DeathLock16/STM32-Drone/Drone_3D/Drone-1.png

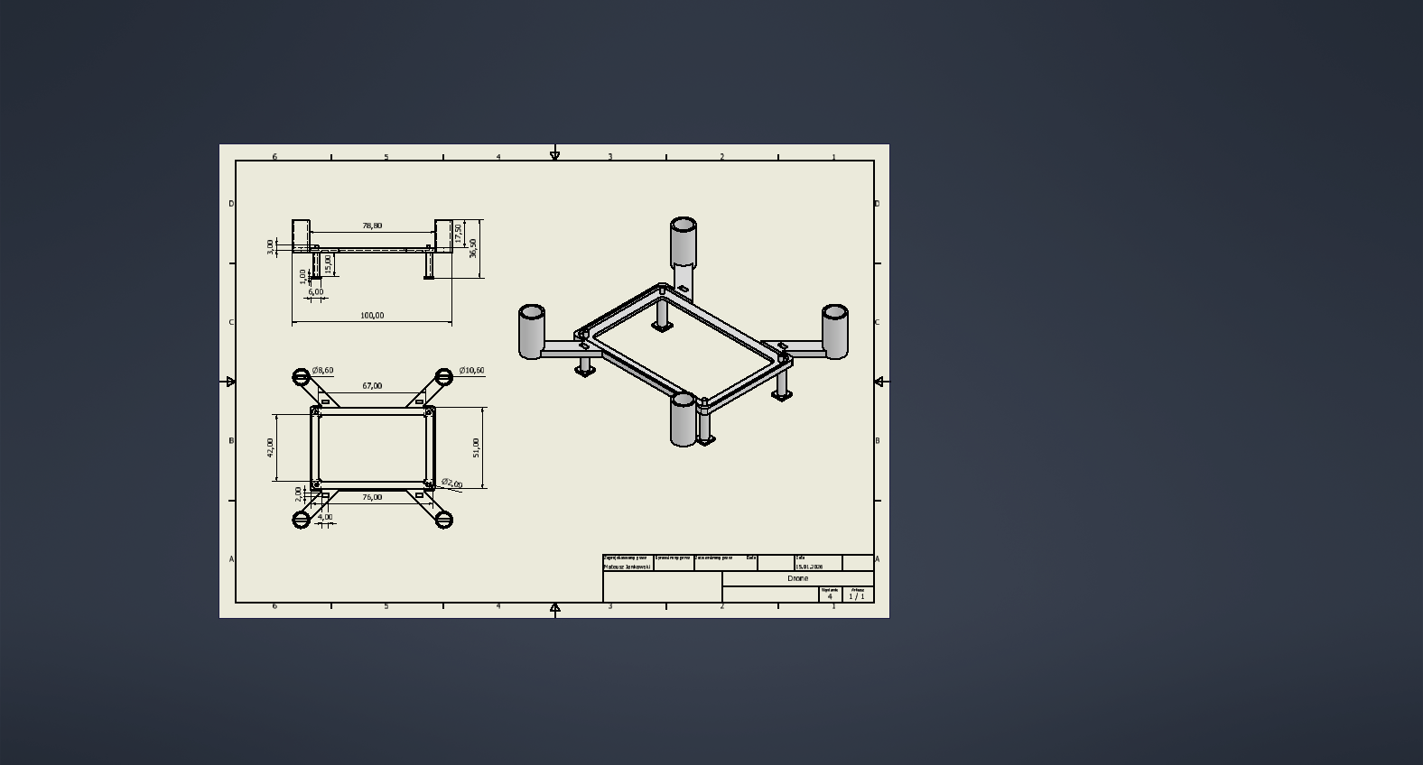
Drone_3D/Drone-1.png
