DeathLock16/STM32-Drone/Drone_3D/Drone.png

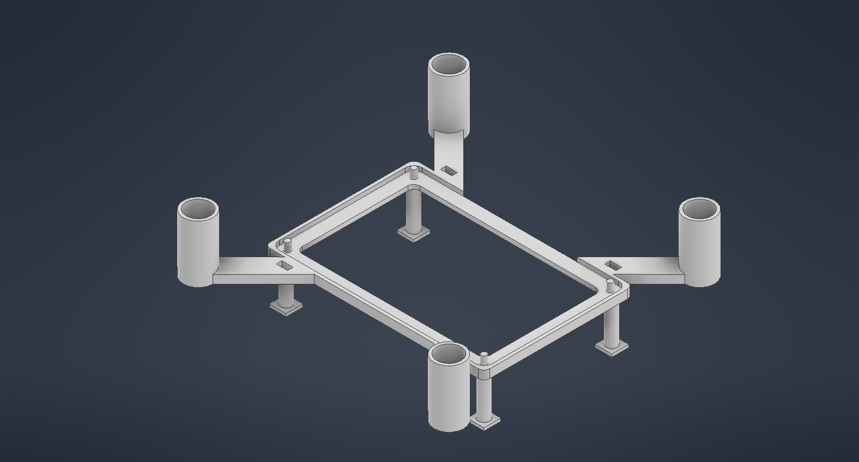
Drone_3D/Drone.png
