DeathLock16/STM32-Drone/Drone_PCB/Drone_PCB.png

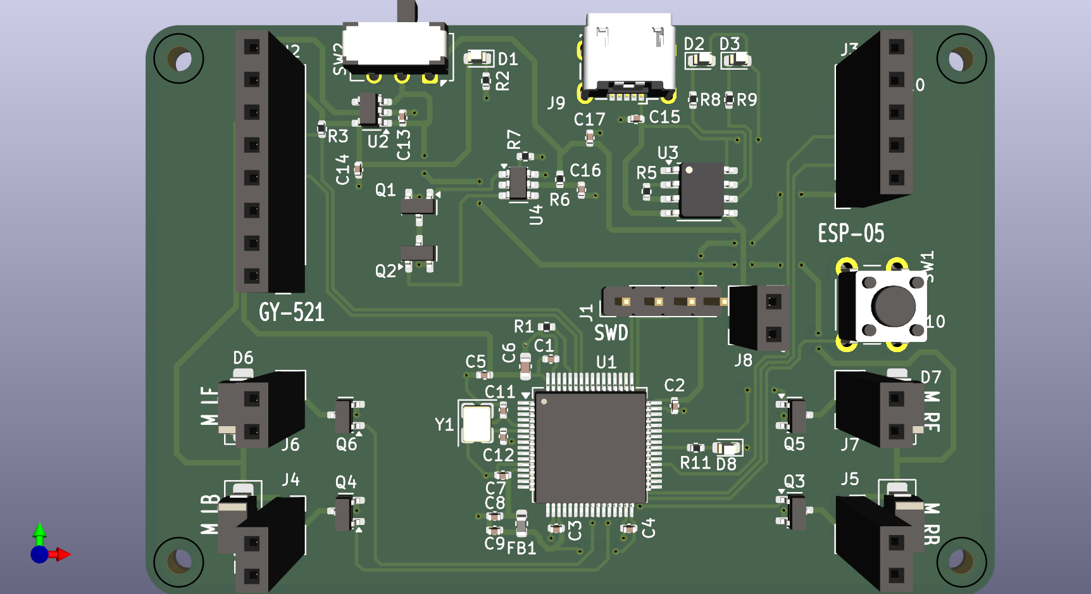
Drone_PCB/Drone_PCB.png
