DeathLock16/STM32-Drone/Drone_3D/Full_model.stl

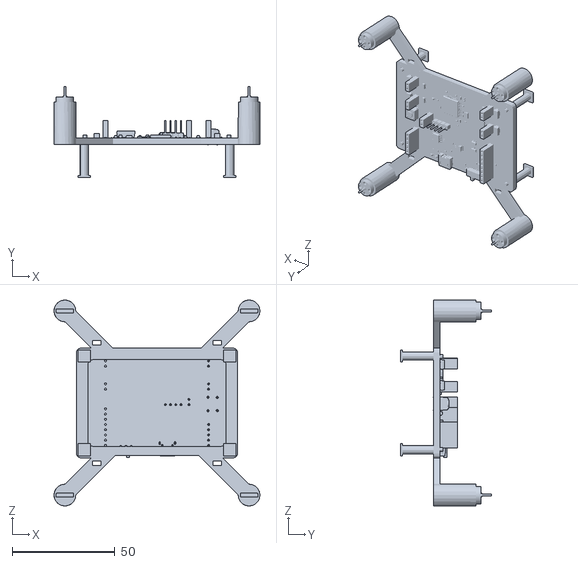
[picture p4: CAD file, 2026-02-10]
Drone_3D/Full_model.stl
100.0 x 44.0 x 100.0
