DeathLock16/STM32-Drone/Drone_3D/Drone.3mf

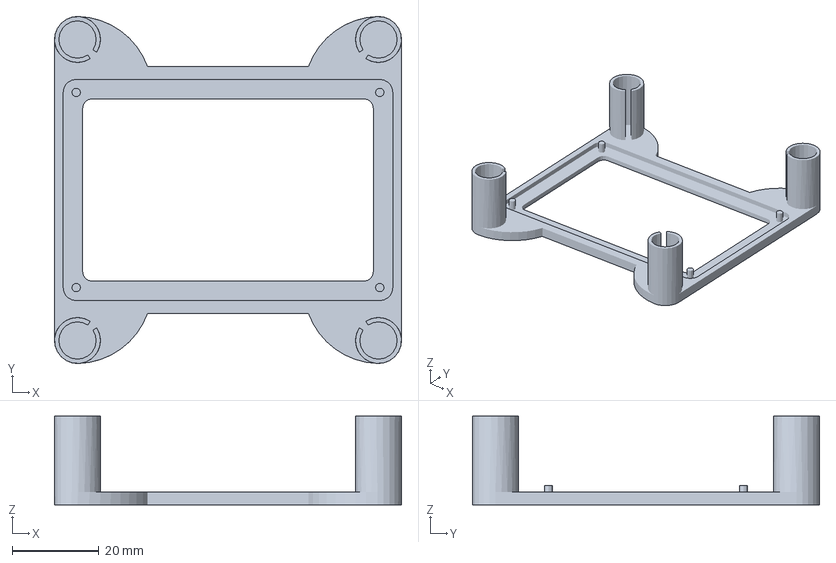
[picture p5: CAD file, 2026-01-23]
Drone_3D/Drone.3mf
80.0 x 80.0 x 20.5 mm
