DeathLock16/STM32-Drone/Drone_3D/8520 Coreless Brshed motor.stl

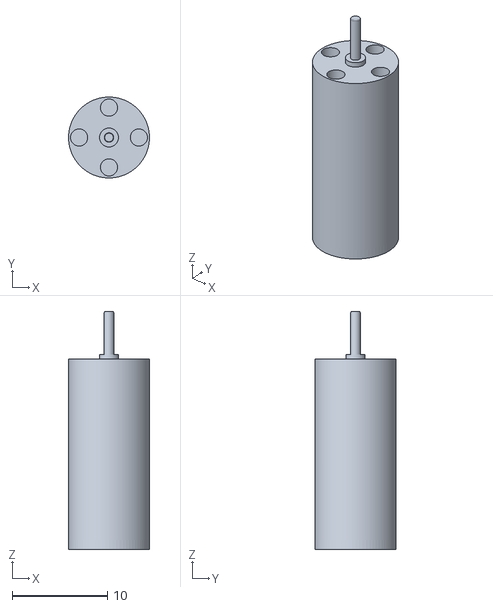
[picture p6: CAD file, 2026-01-22]
Drone_3D/8520 Coreless Brshed motor.stl
8.50 x 8.50 x 25.0
