DeathLock16/STM32-Drone/Drone_3D/Drone_PCB.stl

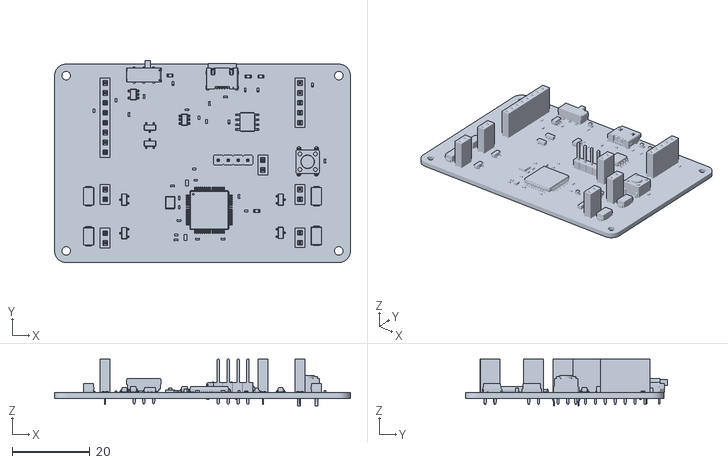
[picture p7: CAD file, 2026-01-22]
Drone_3D/Drone_PCB.stl
76.0 x 51.9 x 12.0
