DeathLock16/STM32-Drone/(list of files, cad)

Other CAD files:
Drone_3D/Drone-1.dwg
Desktop_App/Simulation/drone.blend
Drone_3D/8520 Coreless Brshed motor.ipt
Drone_3D/Część1.ipt
Drone_3D/Drone.ipt
Drone_3D/Drone.stl
Drone_3D/Drone_PCB.ipt
Drone_3D/Motor_Holder.ipt
Drone_3D/OldVersions/Drone.0008.ipt
Drone_3D/OldVersions/Drone_PCB.0001.ipt
Drone_3D/OldVersions/Zespół1.0002.iam
Drone_3D/Zespół1.iam
