DeathLock16/STM32-Drone/Drone_3D/Drone-1.pdf

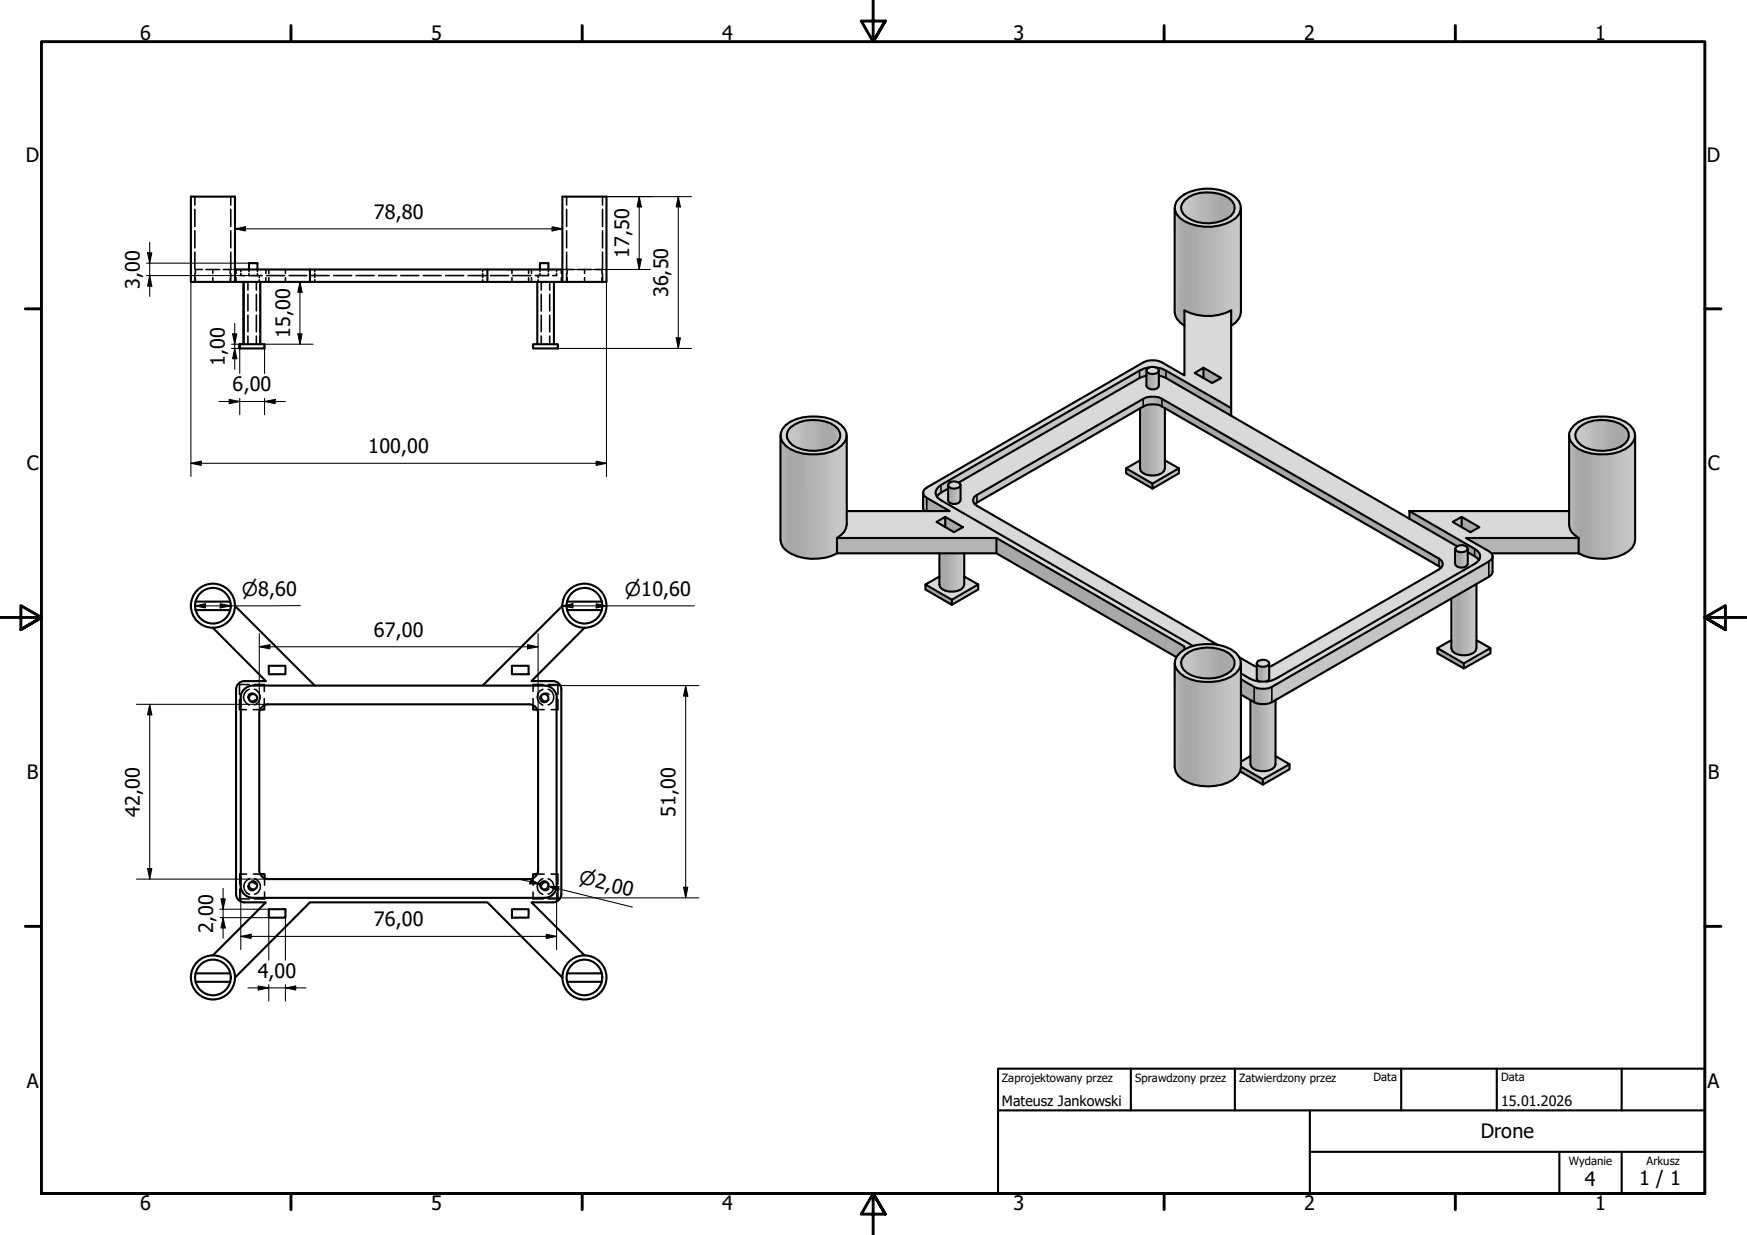
[picture p9: page 1]

Zaprojektowany przez Mateusz Jankowski | Sprawdzony przez | Zatwierdzony przez Data | Data 15.01.2026

Drone

Wydanie 4 | Arkusz 1 / 1
