DeathLock16/STM32-Drone/(list of files, drawings)

Other design files:
Drone_PCB/SumilIDE Simulation.sim1
