DeathLock16/STM32-Drone/Drone_PCB/Drone_PCB.kicad_pcb

## KiCad design Drone_PCB/Drone_PCB.kicad_pcb (2025-12-16)

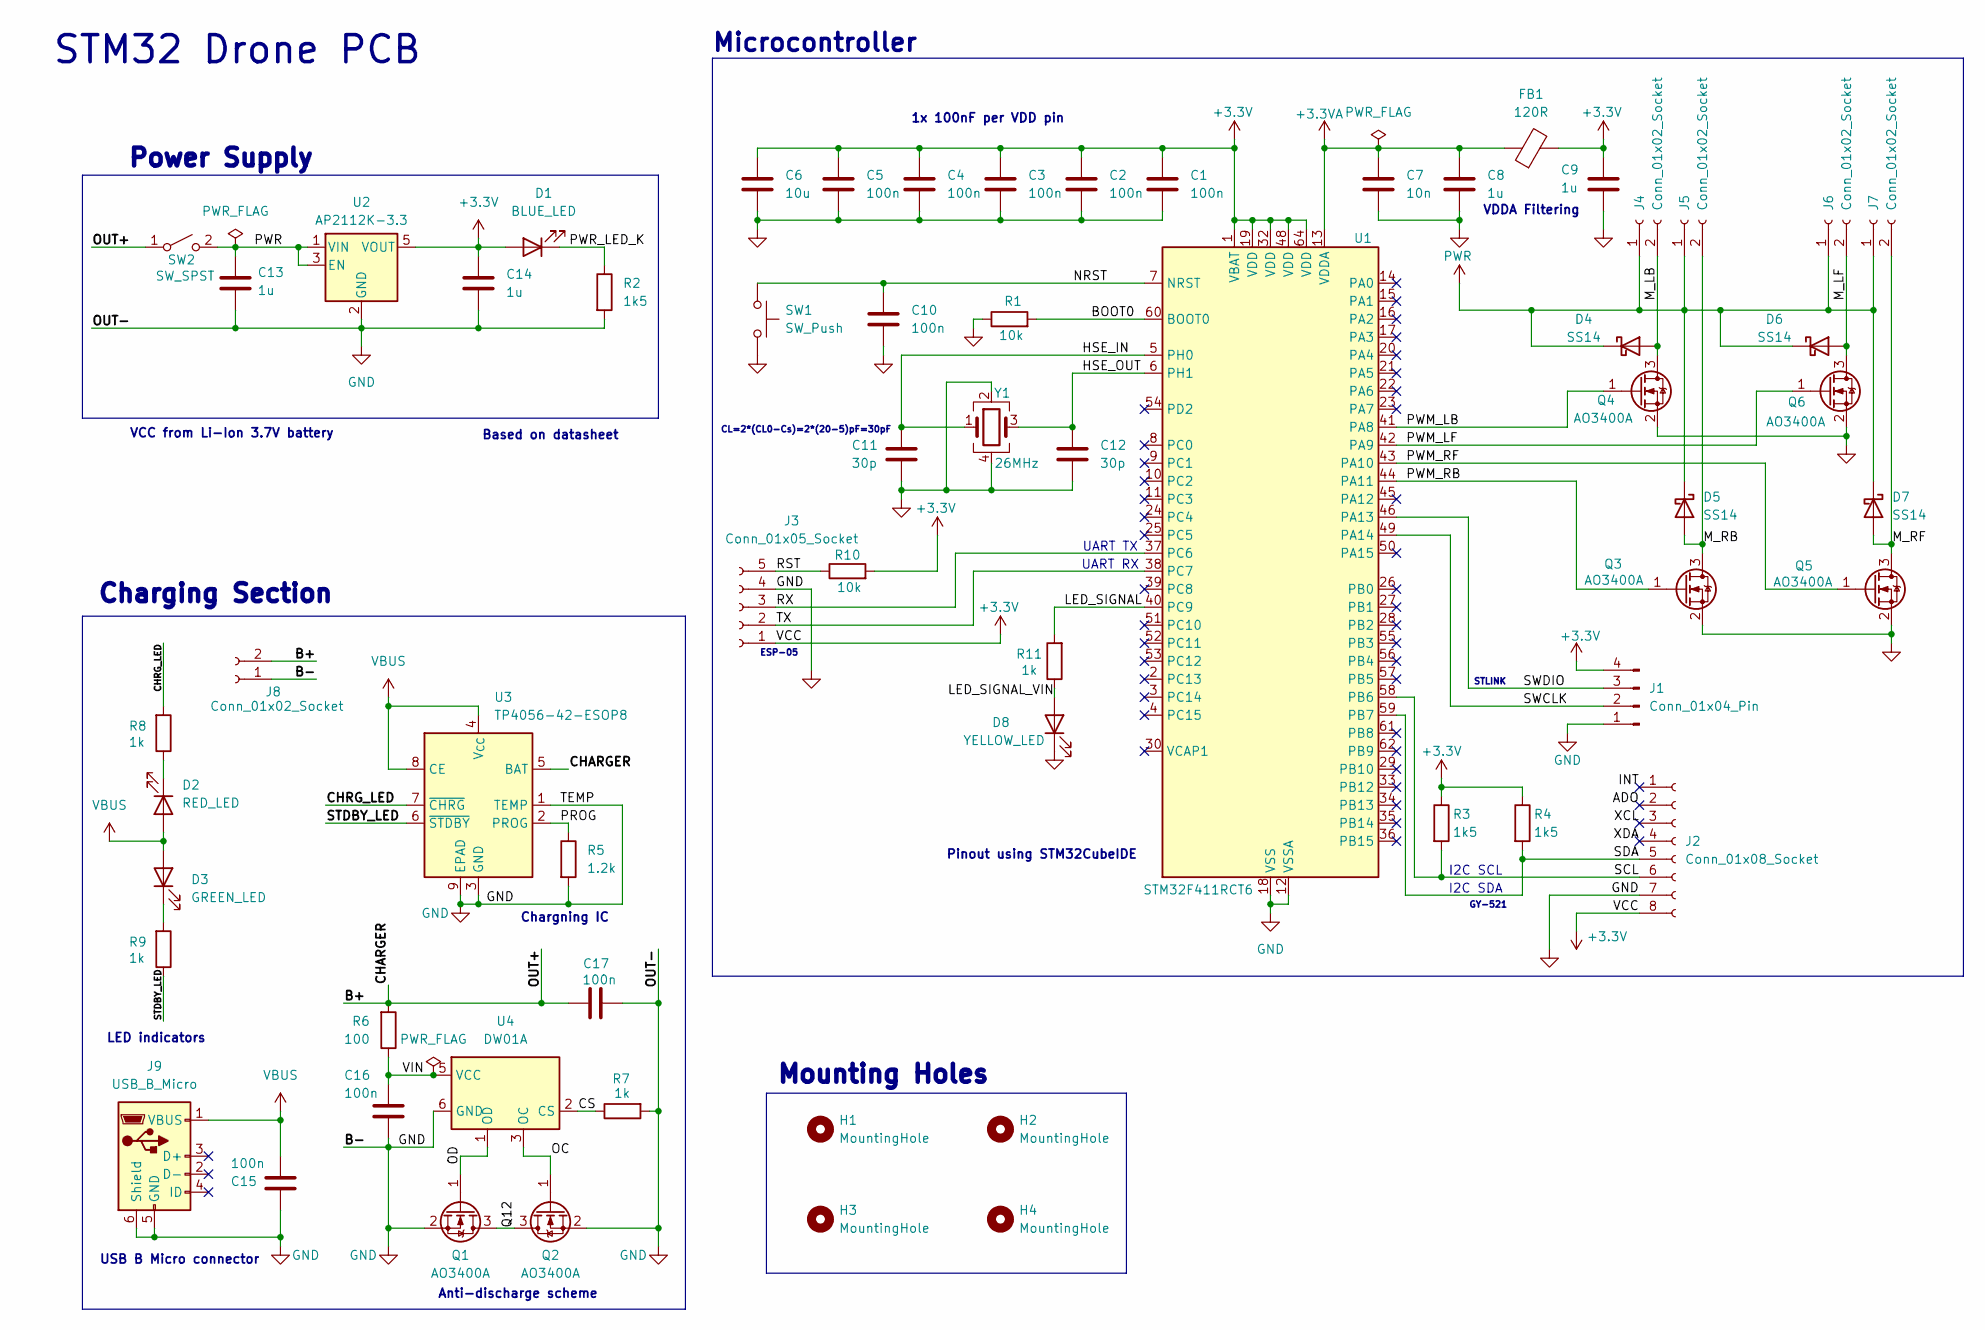
[picture p10: schematic Drone_PCB.kicad_sch, STM32 Drone PCB]

Parts:
C1, C2, C3, C4, C5, C10, C15, C16, C17: 100n; C_0402_1005Metric
C6: 10u; C_0603_1608Metric
C7: 10n; C_0402_1005Metric
C8, C9, C13, C14: 1u; C_0402_1005Metric
C11, C12: 30p; C_0402_1005Metric
D1: BLUE_LED; LED_0603_1608Metric
D2: RED_LED; LED_0603_1608Metric
D3: GREEN_LED; LED_0603_1608Metric
D4, D5, D6, D7: SS14; D_SMA
D8: YELLOW_LED; LED_0603_1608Metric
FB1: 120R; L_0603_1608Metric
H1, H2, H3, H4: MountingHole; MountingHole_2.2mm_M2
J1: Conn_01x04_Pin; PinHeader_1x04_P2.54mm_Vertical
J2: Conn_01x08_Socket; PinSocket_1x08_P2.54mm_Vertical
J3: Conn_01x05_Socket; PinSocket_1x05_P2.54mm_Vertical
J4, J5, J6, J7, J8: Conn_01x02_Socket; PinSocket_1x02_P2.54mm_Vertical
J9: USB_B_Micro; USB_Micro-B_Wuerth_629105150521
Q1, Q2, Q3, Q4, Q5, Q6: AO3400A; SOT-23
R1, R10: 10k; R_0402_1005Metric
R2, R3, R4: 1k5; R_0402_1005Metric
R5: 1.2k; R_0402_1005Metric
R6: 100; R_0402_1005Metric
R7, R8, R9, R11: 1k; R_0402_1005Metric
SW1: SW_Push; SW_PUSH_6mm
SW2: SW_SPST; SW_CK_JS202011AQN_DPDT_Angled
U1: STM32F411RCT6; LQFP-64_10x10mm_P0.5mm
U2: AP2112K-3.3; SOT-23-5
U3: TP4056-42-ESOP8; SOIC-8-1EP_3.9x4.9mm_P1.27mm_EP2.41x3.3mm_ThermalVias
U4: DW01A; SOT-23-6
Y1: 26MHz; Crystal_SMD_3225-4Pin_3.2x2.5mm

Connections:
+3.3V: C1.1, C2.1, C3.1, C4.1, C5.1, C6.1, C9.1, C14.1, D1.2 (A), FB1.2, J1.4, J2.8, J3.1, R3.1, R4.1, R10.2, U1.1 (VBAT), U1.19 (VDD), U1.32 (VDD), U1.48 (VDD), U1.64 (VDD), U2.5 (VOUT)
+3.3VA: C7.1, C8.1, FB1.1, U1.13 (VDDA)
/ADO: J2.2
/B+: C17.1, J8.2, R6.2, SW2.1 (A), U3.5 (BAT)
/BOOT0: R1.2, U1.60 (BOOT0)
/CHRG_LED: R8.2, U3.7 (~CHRG)
/CS: R7.1, U4.2 (CS)
/HSE_IN: C11.1, U1.5 (PH0), Y1.1
/HSE_OUT: C12.1, U1.6 (PH1), Y1.3
/INT: J2.1
/LED_SIGNAL: R11.2, U1.40 (PC9)
/LED_SIGNAL_VIN: D8.2 (A), R11.1
/M_LB: D4.2 (A), J4.2, Q4.3 (D)
/M_LF: D6.2 (A), J6.2, Q6.3 (D)
/M_RB: D5.2 (A), J5.2, Q3.3 (D)
/M_RF: D7.2 (A), J7.2, Q5.3 (D)
/NRST: C10.1, SW1.1, U1.7 (NRST)
/OC: Q2.1 (G), U4.3 (OC)
/OD: Q1.1 (G), U4.1 (OD)
/PROG: R5.1, U3.2 (PROG)
/PWM_LB: Q4.1 (G), U1.41 (PA8)
/PWM_LF: Q6.1 (G), U1.42 (PA9)
/PWM_RB: Q3.1 (G), U1.44 (PA11)
/PWM_RF: Q5.1 (G), U1.43 (PA10)
/PWR_LED_K: D1.1 (K), R2.1
/Q12: Q1.3 (D), Q2.3 (D)
/RST: J3.5, R10.1
/RX: J3.3, U1.37 (PC6)
/SCL: J2.6, R3.2, U1.58 (PB6)
/SDA: J2.5, R4.2, U1.59 (PB7)
/STDBY_LED: R9.1, U3.6 (~STDBY)
/SWCLK: J1.2, U1.49 (PA14)
/SWDIO: J1.3, U1.46 (PA13)
/TX: J3.2, U1.38 (PC7)
/VIN: C16.1, R6.1, U4.5 (VCC)
/XCL: J2.3
/XDA: J2.4
GND: C1.2, C2.2, C3.2, C4.2, C5.2, C6.2, C7.2, C8.2, C9.2, C10.2, C11.2, C12.2, C13.2, C14.2, C15.1, C16.2, C17.2, D8.1 (K), J1.1, J2.7, J3.4, J8.1, J9.5 (GND), J9.6 (Shield), Q1.2 (S), Q2.2 (S), Q3.2 (S), Q4.2 (S), Q5.2 (S), Q6.2 (S), R1.1, R2.2, R5.2, R7.2, SW1.2, U1.12 (VSSA), U1.18 (VSS), U1.31 (VSS), U1.47 (VSS), U1.63 (VSS), U2.2 (GND), U3.1 (TEMP), U3.3 (GND), U3.9 (EPAD), U4.6 (GND), Y1.2, Y1.4
unnamed: D2.1 (K), R8.1
unnamed: D3.1 (K), R9.2
PWR: C13.1, D4.1 (K), D5.1 (K), D6.1 (K), D7.1 (K), J4.1, J5.1, J6.1, J7.1, SW2.2 (B), U2.1 (VIN), U2.3 (EN)
VBUS: C15.2, D2.2 (A), D3.2 (A), J9.1 (VBUS), U3.4 (V_{CC}), U3.8 (CE)

Notes on the sheet:
CL=2*(CL0-Cs)=2*(20-5)pF=30pF
Mounting Holes
GY-521
Pinout using STM32CubeIDE
UART TX
USB B Micro connector
UART RX
Power Supply
LED indicators
Chargning IC
VCC from Li-Ion 3.7V battery
I2C SDA
STM32 Drone PCB
1x 100nF per VDD pin
Based on datasheet
ESP-05
Anti-discharge scheme
Microcontroller
Charging Section
VDDA Filtering
STLINK
I2C SCL

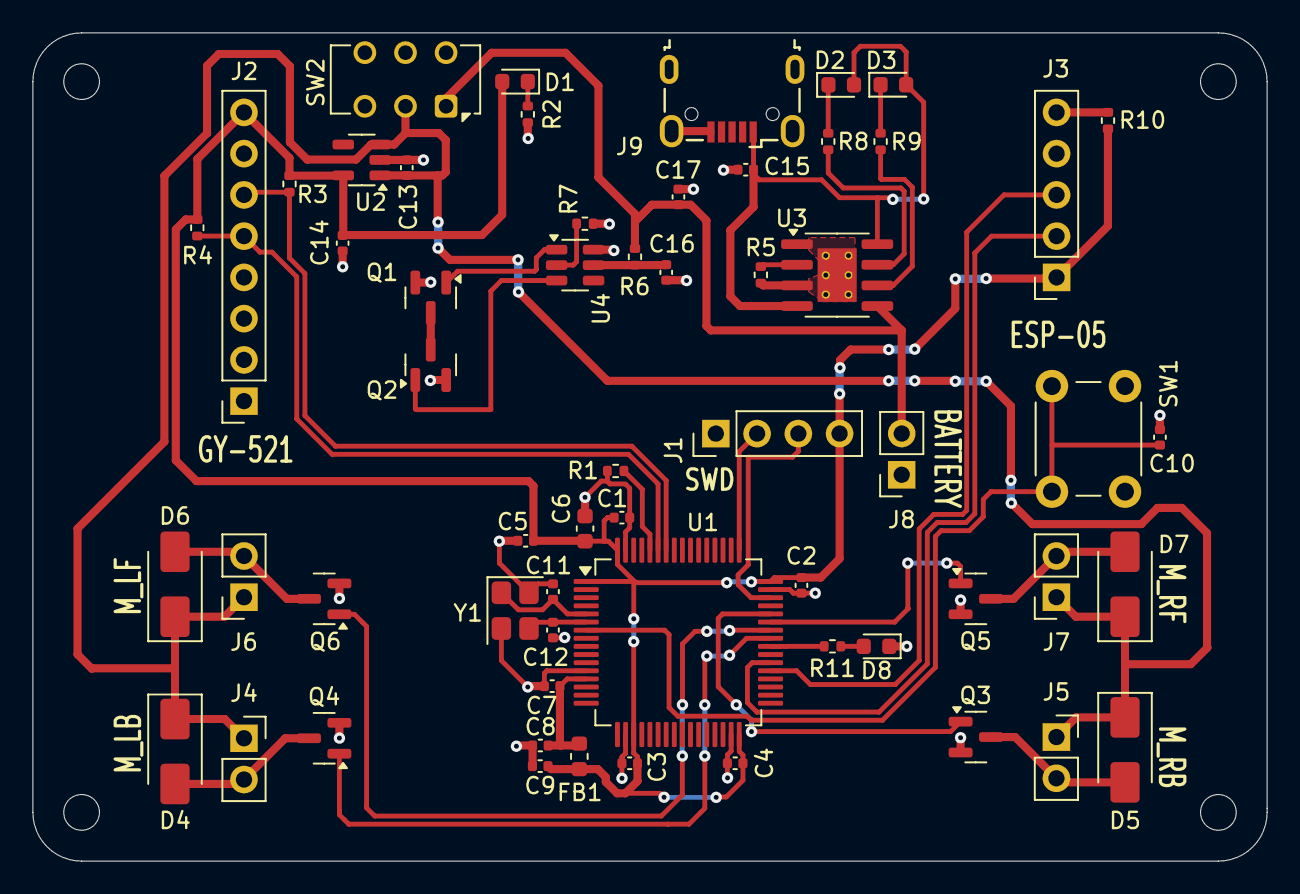
[picture p11: board Drone_PCB.kicad_pcb from above]

Board: 2 copper layers, 76.0 x 51.0 mm, 63 parts (0 on the bottom side), 38 nets.
