DeathLock16/STM32-Drone/STM32-Drone-Project/STM32-Drone-Project.ioc

Mcu.UserName=STM32F411RCTx
PA10.GPIO_Label=MOTOR_RF
PA10.Signal=S_TIM1_CH3
PA11.GPIO_Label=MOTOR_RB
PA11.Signal=S_TIM1_CH4
PA13.Signal=SYS_JTMS-SWDIO
PA14.Signal=SYS_JTCK-SWCLK
PA8.GPIO_Label=MOTOR_LB
PA8.Signal=S_TIM1_CH1
PA9.GPIO_Label=MOTOR_LF
PA9.Signal=S_TIM1_CH2
PB6.Signal=I2C1_SCL
PB7.Signal=I2C1_SDA
PC14-OSC32_IN.Signal=RCC_OSC32_IN
PC15-OSC32_OUT.Signal=RCC_OSC32_OUT
PC6.Signal=USART6_TX
PC7.Signal=USART6_RX
PC9.GPIO_Label=LED_SIGNAL
PC9.Signal=GPIO_Output
