DeathLock16/STM32-Drone/(commit log)

2025-06-19 Created KiCad project
    We'll create PCB Board by ourselves
    [Drone_PCB.kicad_pcb, Drone_PCB.kicad_sch]
2025-06-19 Created STM32 CubeIDE Project
    Our chosen MCU: STM32F411RCT6
2025-06-19 First scheme
    Added MCU + VSS/VDD
    [Drone_PCB.kicad_sch]
2025-06-21 Power output
    NRST and BOOT0 pins are now connected.
    NRST via Capacitor to GND
    BOOT0 via 10k Resistor to GND ( enable SWD programming )
    [Drone_PCB.kicad_sch]
2025-06-21 Outputs
    Created outputs in our STM32 CubeIDE Project and in KiCad:
    - SWD
    - RCC_OSC
    - USART1
    - I2C1
    - MOTORs
    - LED_SIGNAL
    [Drone_PCB.kicad_sch]
2025-06-21 Crystal Oscillator
    I've decided to pick this one:
    https://www.tme.eu/pl/details/26.00m-smdhc49s/rezonatory-kwarcowe-smd/yic/
    It has 26MHz ( it's maximum input from STM Cube IDE ). It has 20pF, so to calculate two other capacitors we do this: 20pF - 5pF (that's maximum constant value)
    15pF * 2 = 30pF each
    [Drone_PCB.kicad_sch]
2025-06-22 Voltage regulator + Outputs
    I selected AP2112K as voltage regulator from 5/3.7V to 3.3V.
    https://www.tme.eu/pl/details/ap2112k-3.3trg1/stabilizatory-napiecia-nieregulowane-ldo/diodes-incorporated/
    In future I will add charging module
    [Drone_PCB.kicad_sch]
2025-06-22 Notes and other output
    Added outputs for LED_SIGNAL, MOTORs and proper connection of SWD. Also added schmatic notes
    [Drone_PCB.kicad_sch]
2025-06-22 Added charging module
    FIX THAT connections are wrong 4some reason
    [Drone_PCB.kicad_sch]
2025-06-23 Fixed errors
    Now everything looks good
    [Drone_PCB.kicad_sch]
2025-06-23 Footprint assignment
    We assigned footprints
    [Drone_PCB.kicad_sch]
2025-06-23 Updated footprint
    There were missing objects
    [Drone_PCB.kicad_pcb, Drone_PCB.kicad_sch]
2025-06-23 Creating PCB part 1
    Circuit is looking pretty neat
    [Drone_PCB.kicad_pcb, Drone_PCB.kicad_sch]
2025-08-26 Adjusted some pinouts
    Corrected pinouts for motors leds and communication modules
    [Drone_PCB.kicad_sch]
2025-08-26 Updated motors
    We control MOSFETS with PWM so there will not be any overcurrent
    [Drone_PCB.kicad_sch]
2025-08-26 Updated charging section
    Changed NMOS transistors + diodes to VBUS
    [Drone_PCB.kicad_sch]
2025-11-04 Added NRST button
    Following the advice of Dr. Puchalski, I added NRST button. Additionally, I tidied up the engine area more.
    [Drone_PCB.kicad_sch]
2025-11-04 Switching THD Signal LED to SMD
    It will be better I guess
    [Drone_PCB.kicad_sch]
2025-11-04 Changed TP4056 symbol
    BAT is passive now due to KiCad errors about multiple Power Outputs
    [Drone_PCB.kicad_sch]
2025-11-04 Battery output + changing few things
    Absolutely forgot about power source socket ( battery )
    [Drone_PCB.kicad_sch]
2025-11-04 Chose elements
    I guess it's all of them
    [Drone_PCB.kicad_sch]
2025-11-04 PCB #1
    MCU, Decoupling Capacitors and Crystal layout
    [Drone_PCB.kicad_pcb]
2025-11-04 SWD Layout
    Added SWD pinout
    [Drone_PCB.kicad_pcb]
2025-11-04 Fixed missing models
    Sike
    [629105150521.stp, Drone_PCB.kicad_pcb]
2025-11-04 Arranged I2C, UART and SWD
    It looks okay
    [Drone_PCB.kicad_pcb]
2025-11-04 PCB #2
    Created charging section
    [Drone_PCB.kicad_pcb, Drone_PCB.kicad_sch]
2025-11-04 PCB #3
    Added motors
    [Drone_PCB.kicad_pcb, Drone_PCB.kicad_sch]
2025-11-04 PCB #4
    Connected signal LED, everything is connected
    [Drone_PCB.kicad_sch]
2025-11-05 Fast update
    PCB didn't save last time
    [Drone_PCB.kicad_pcb]
2025-11-09 Added Mounting Holers + Edges
    Now PCB is almost ready in 3D terms
    [Drone_PCB.kicad_pcb, Drone_PCB.kicad_sch]
2025-11-28 Created router using FreeRouting
    We switched Bottom Layer to signal to enable FreeRouting
    [Drone_PCB.kicad_pcb]
2025-11-28 Increase drill size and add silkscreen labels
    Updated several pad drill sizes from 0.2mm to 0.3mm for improved manufacturability. Added silkscreen text labels for connectors and components, and updated PCB routing and backup files to reflect latest design changes.
    [Drone_PCB.kicad_pcb]
2025-11-28 Update PCB backup file
    Replaced the previous PCB backup (2025-11-28_123159.zip) with a new version (2025-11-28_145056.zip) to maintain up-to-date project backups.
2025-11-28 Update PCB project and add manufacturing files
    Updated PCB and project files to output manufacturing data to the 'manufacturing/' directory. Added Gerber, drill, BOM, position, and STL files for fabrication. Removed obsolete backup and lock files, and added new PCB backup archives.
    [Drone_PCB-BOM.csv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]
2025-12-04 Changed schematic
    FreeRouting does kinda lame job. Removed routes and moved some elements
    [Drone_PCB.kicad_pcb]
2025-12-04 Added GND routes
    It should work okay now
    [Drone_PCB.kicad_pcb, Drone_PCB.kicad_sch]
2025-12-04 Made the rest of routes-ish
    Sort of
    [Drone_PCB.kicad_pcb]
2025-12-05 Full routing
    Man, that was hard
    [Drone_PCB.kicad_pcb]
2025-12-05 Final routes
    I guess it's okay now
    [Drone_PCB.kicad_pcb, Drone_PCB.kicad_sch, SumilIDE Simulation.sim1]
2025-12-16 Last touches
    All changes exported to JLCPCB
    [Drone_PCB-BOM.csv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]
2025-12-28 STM32 Gyroscope code
    Used Madgwick to read data and Blender script for simulating Drone movement
2025-12-28 Switched already to ESP-05 communication
    4some reason I have to click Reset button on start, my fault I guess during the scheme creation. Anyway, communication is via WiFi
2025-12-29 Frames system
    From now on, we can calculate frames and send/receive them
2025-12-29 Switched to 10k PWM
    That value seems more logical to set. Made new commands in test script. Note - motor drains too much current, we have to add Capacitor.
    [STM32-Drone-Project.ioc, main.c, protocol.c, protocol.h, terminal_control.py]
2025-12-30 Added IMU Frame
    We're recalculating it in while loop, so data will always be somehow proper
2026-01-22 Created 3D models
    [8520 Coreless Brshed motor.ipt, 8520 Coreless Brshed motor.stl, Część1.ipt, Drone.0003.ipt, Drone.ipt, Drone.stl, Drone_PCB.0001.ipt, Drone_PCB.ipt]
2026-01-23 Used OrcaSlicer for slicing 3d model
    [Drone.3mf]
2026-01-24 Added acceleration filter + shut-off
    If the angle is >= 45 degrees, then PWMs are shut off
2026-01-24 Auto stabilization
    + KP regulator
2026-01-24 Updated failed start
    Also fixed a bug
    [main.c, terminal_control.py]
2026-01-24 Added YAW balance
    It will not rotate as much as before
2026-01-24 Fixed small bug
    Repetition of variable
    [main.c]
2026-01-25 Added best possible filtration
    For now, the weight (79g) is just too big, so the basic movement is possible only
    [main.c, protocol.h]
2026-01-25 Created 3d model viewer
    We will update it soon
    [Full_model.stl]
2026-01-25 Resigned from 3D viewer
    Was not working well
    [ControlApp.py]
2026-01-25 Updated model
    Not it's current model
2026-01-25 PID tuning
2026-01-25 Added AUTO RAMP
    It increases smoothly the PWM
2026-01-25 Added PWM plots
    It helps diagnosing errors
    [ControlApp.py, main.c]
2026-01-25 Created telemetry frame
    It sends all telemetry data in 1 packet
2026-01-26 Created ground testing environment
    Turns will be more aggresive
2026-01-27 Desktop app exports data
    It exports telemetry data for tuning. Also added navigation directions
    [Drone.0003.ipt, Drone.0004.ipt, Drone.ipt, Drone.stl]
2026-01-28 Tuning again
    Created new model with support from below for imu stabilization
    [Drone.0004.ipt, Drone.0006.ipt, Drone.ipt, Drone.stl]
2026-02-05 IMU calibration
    Changed a way that IMU calibrates itself and added new telemetry frame
2026-02-10 Final tuning + Logger app + a lot
    Changed kinda lot
    [Drone-1.dwg, Drone.0007.ipt, Drone.0008.ipt, Drone.ipt, Full_model.stl, Zespół1.0001.iam, Zespół1.0002.iam, Zespół1.iam]
2026-02-18 Include thesis
    [drone.blend]
2026-03-01 Updated blender file
    Simulation now shows only IMU, Telemetry is useless for this
    [drone.blend]
