DeathLock16/STM32-Drone/(notices)

Notices in the files:
STM32-Drone-Project/Core/Inc/main.h:
Copyright (c) 2025 STMicroelectronics.
All rights reserved.
This software is licensed under terms that can be found in the LICENSE file
